sassythesasquatchh/Aeroponics-Module/Electrical Subsytem/Power Requirements.xlsx

Item | Quantity | Current (mA) | Voltage (V) | Power (W) | Total Current (mA) | Total Power (W)
Main Pump | 1 | 300 | 120 | 20 | 300 | 20
Nutrient Pump | 2 | 40 | 120 | 3 | 80 | 6
Subtotal |  |  |  |  | 380 | 26
Arduino | 1 | 50 | 5 | 0.25 | 50 | 0.25
ESP32 | 1 | 250 | 3.3 | 0.825 | 250 | 0.825
TDS | 1 | 6 | 3.3 | 0.0198 | 6 | 0.0198
PH | 1 | 10 | 5 | 0.05 | 10 | 0.05
Light | 1 | 0.02 | 5 | 0.0001 | 0.02 | 0.0001
CO2 | 1 | 125 | 5 | 0.625 | 125 | 0.625
O2 | 1 | 100 | 5 | 0.5 | 100 | 0.5
Subtotal |  |  |  |  | 541.02 | 2.2699
Total |  |  |  |  | 921.02 | 28.2699
Item | Quantity | Current (mA) | Voltage (V) | Power (W) | Total Current (mA) | Total Power (W)
Main Pump | 1 | 300 | 120 | 20 | 300 | 20
Nutrient Pump | 2 | 40 | 120 | 3 | 80 | 6
Subtotal |  |  |  |  | 380 | 26
Arduino | 1 | 50 | 5 | 0.25 | 50 | 0.25
ESP32 | 1 | 250 | 5 | 1.25 | 250 | 1.25
TDS | 1 | 6 | 5 | 0.03 | 6 | 0.03
PH | 1 | 10 | 5 | 0.05 | 10 | 0.05
Light | 1 | 0.02 | 5 | 0.0001 | 0.02 | 0.0001
CO2 | 1 | 125 | 5 | 0.625 | 125 | 0.625
O2 | 1 | 100 | 5 | 0.5 | 100 | 0.5
Subtotal |  |  |  |  | 541.02 | 2.7051
Total |  |  |  |  | 921.02 | 28.7051
