sassythesasquatchh/Aeroponics-Module/App/AWS_Flow_Diagram.png

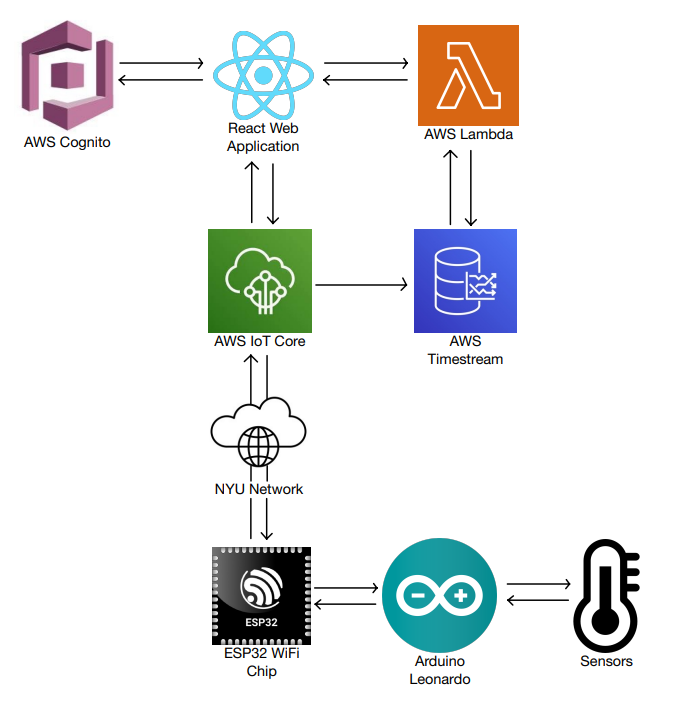
App/AWS_Flow_Diagram.png
