sassythesasquatchh/Aeroponics-Module/Electrical Subsytem/3-Pumps-Driver Layout.png

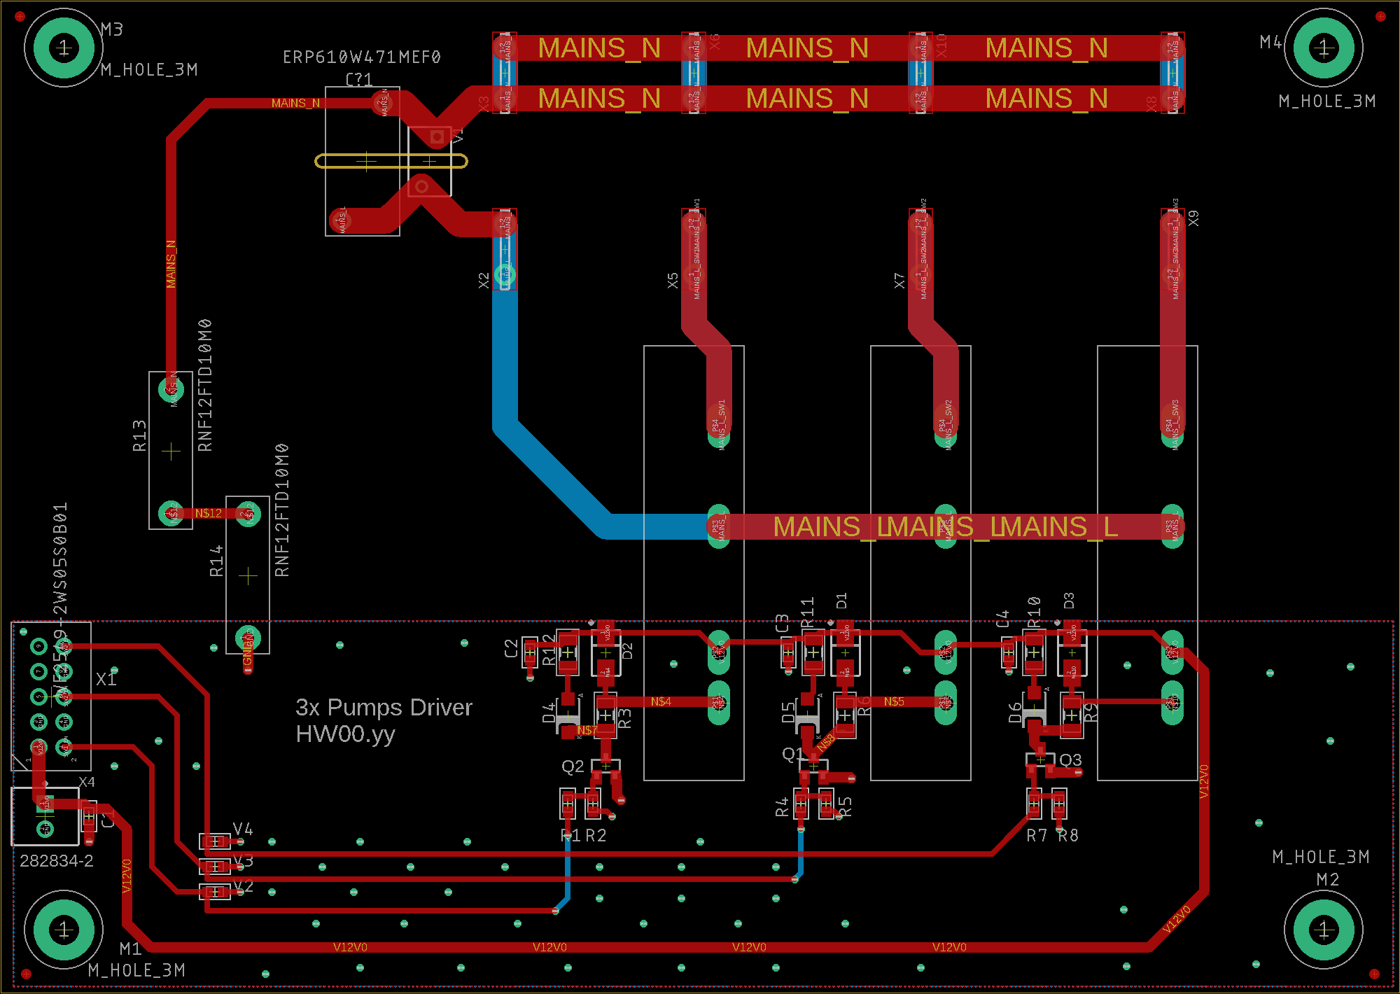
Electrical Subsytem/3-Pumps-Driver Layout.png
