sassythesasquatchh/Aeroponics-Module/Electrical Subsytem/3-Pumps-Driver.png

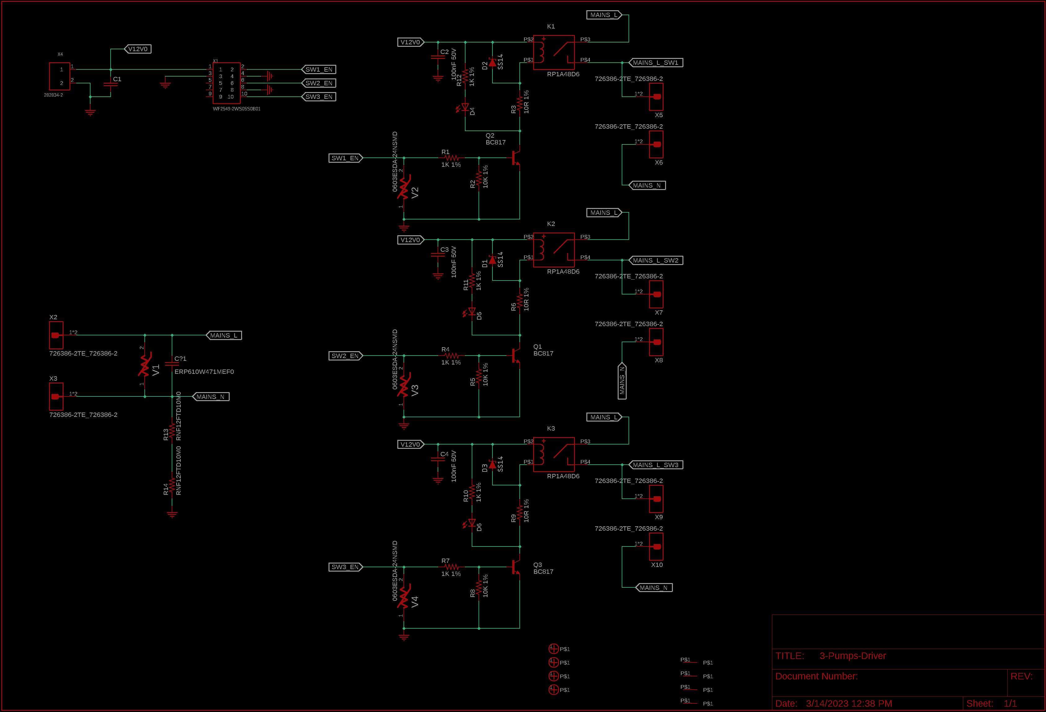
Electrical Subsytem/3-Pumps-Driver.png
