sassythesasquatchh/Aeroponics-Module/Electrical Subsytem/Dosing Control Diagram.png

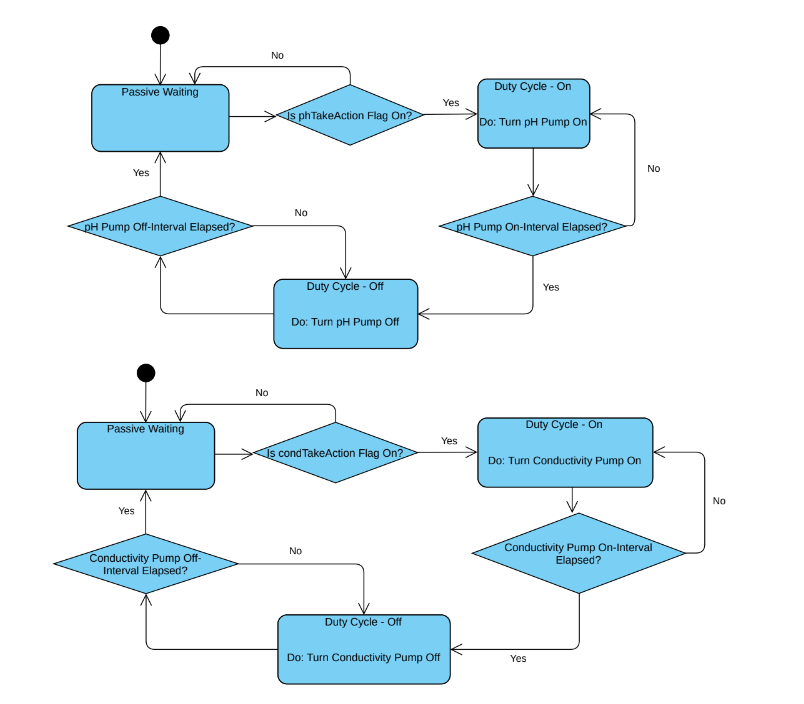
Electrical Subsytem/Dosing Control Diagram.png
