sassythesasquatchh/Aeroponics-Module/Electrical Subsytem/Schematic.jpg

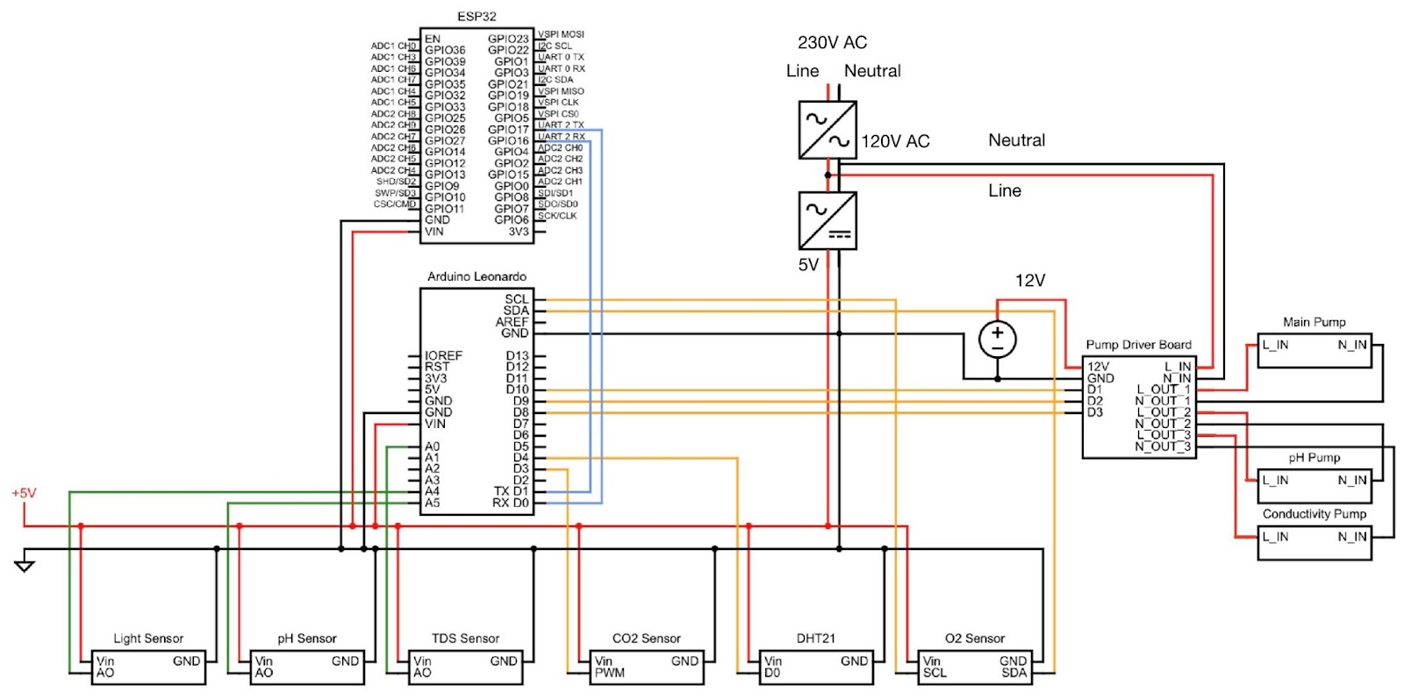
Electrical Subsytem/Schematic.jpg
