sassythesasquatchh/Aeroponics-Module/Bill of Materials.xlsx

Item Name | Quantity | Cost per unit ($) | Total Cost per Item ($) | Total Cost ($)
Main Pump (https://www.amazon.com/EcoPlus-Submersible-Aquarium-Fountain-Hydroponics/dp/B0018X2XT4) | 1 | 28.8 | 28.8 | 911.328
Conductivity Sensor (https://www.amazon.com/Conductivity-Hydroponics-Waterproof-Monitoring-Detection/dp/B08SQGL728) | 1 | 17.43 | 17.43
pH Sensor (https://www.amazon.com/dp/B0799BXMVJ/?coliid=I15NAHT9G5DQEI&colid=10N2NBCQJFRYH) | 1 | 34.99 | 34.99
PVC Elbow Joints 0.5in (https://www.amazon.com/Rainbow-Dream-2-Inch-Degree-Elbow/dp/B092MJ3T72) | 1 | 0.93 | 0.93
PVC Pipe (5ft) (https://www.mcmaster.com/products/pipe/standard-wall-plastic-pipe-for-water/?s=pvc+pipe) | 1 | 7.8 | 7.8
Marine Grade Plywood Cladding (1/2"x48"x96") (https://www.mcmaster.com/1125T613/) | 6 | 30.75 | 184.5
Arduino Leonardo (https://www.amazon.com/ELEGOO-Board-ATmega328P-ATMEGA16U2-Compliant/dp/B01EWOE0UU) | 1 | 25 | 25
ESP32 Development Board (https://www.amazon.com/Teyleten-Robot-ESP-WROOM-32-Development-Microcontroller/dp/B08246MCL5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) | 1 | 6 | 6
Timber Framing (2x4x96") (https://www.mcmaster.com/products/timber/wood-boards/) | 8.2 | 5.79 | 47.478
Plastic Sheeting (0.023"x24"x45") (https://www.mcmaster.com/products/plastic-sheets/slippery-uhmw-polyethylene-film/) | 10 | 9.09 | 90.9
WiFi Antenna (https://www.amazon.com/Diymall-Antenna-Antennas-Arduino-ESP-072pcs/dp/B00ZBJNO9O) | 1 | 5 | 5
Heavy Duty Velcro (1"x20') (https://www.amazon.com/VELCRO-Brand-Mounting-Adhesive-Concrete/dp/B09BNPHCZX) | 1 | 17.09 | 17.09
PVC Stop Valve (https://www.mcmaster.com/products/stop-valves/for-use-with~water/body-material~plastic/easy-to-install-plastic-threaded-on-off-valves/) | 1 | 34.33 | 34.33
Temperature and Humidity Sensor (https://www.amazon.com/HiLetgo-Temperature-Humidity-Digital-3-3V-5V/dp/B01DKC2GQ0) | 1 | 2 | 2
Breadboard wires (https://www.amazon.com/EDGELEC-Breadboard-Optional-Assorted-Multicolored/dp/B07GD2BWPY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) | 1 | 6.89 | 6.89
Plant wells (https://www.amazon.com/50-Pack-Garden-Slotted-Labels-Hydroponics/dp/B07CVCHM5T) | 1 | 10.95 | 10.95
Misting Nozzles (https://www.amazon.com/Tefen-Plastic-Fogger-Misting-Nozzle/dp/B07YQ4VQ7X) | 1 | 59 | 59
Light Sensors (https://www.amazon.com/HiLetgo-TEMT6000-Sensor-Professional-Arduino/dp/B07WDW9BHD) | 1 | 2.67 | 2.67
CO2 sensor (https://www.amazon.com/DFRobot-Gravity-Analog-Infrared-Arduino/dp/B07CG726Y3) | 1 | 63 | 63
Oxygen Sensor (https://www.amazon.com/Gravity-Compatible-Sensitivity-Stablility-Anti-Interference/dp/B08BL1NLGV) | 1 | 58.9 | 58.9
PermaProto Boards (https://www.amazon.com/Adafruit-Accessories-Perma-Proto-Full-Breadboard/dp/B00SK8KAMM) | 1 | 8.33 | 8.33
Small Nutrient Pump (https://www.amazon.com/Aquaneat-Submersible-Adjustable-Powerhead-Hydroponic/dp/B077955YC2) | 2 | 6.17 | 12.34
Polystyrene Insulation (6pcs@1"x24"x4') (https://www.mcmaster.com/products/polystyrene/moisture-resistant-low-temperature-rigid-polystyrene-foam-insulation-sheets/) | 2.2 | 85 | 187
Pump Driver Board | 1 | 50 | 50
Item Name | Quantity | Cost/unit ($) | Cost/Item ($) | Total Cost ($)
Main Pump (https://www.amazon.com/EcoPlus-Submersible-Aquarium-Fountain-Hydroponics/dp/B0018X2XT4) | 1 | 28.8 | 28.8 | 2610.7
Conductivity Sensor (https://www.amazon.com/Conductivity-Hydroponics-Waterproof-Monitoring-Detection/dp/B08SQGL728) | 2 | 17.43 | 34.86
pH Sensor (https://www.amazon.com/dp/B0799BXMVJ/?coliid=I15NAHT9G5DQEI&colid=10N2NBCQJFRYH) | 2 | 34.99 | 69.98
PVC Elbow Joints 0.5in (https://www.amazon.com/Rainbow-Dream-2-Inch-Degree-Elbow/dp/B092MJ3T72) | 15 | 0.93 | 13.95
PVC Pipe (5ft) (https://www.mcmaster.com/products/pipe/standard-wall-plastic-pipe-for-water/?s=pvc+pipe) | 1 | 7.8 | 7.8
Marine Grade Plywood Cladding (1/2"x48"x96") (https://www.mcmaster.com/products/timber/plywood-sheets/) | 3 | 216.66 | 649.98
Arduino Leonardo (https://www.amazon.com/ELEGOO-Board-ATmega328P-ATMEGA16U2-Compliant/dp/B01EWOE0UU) | 1 | 25 | 25
ESP32 Development Board (https://www.amazon.com/Teyleten-Robot-ESP-WROOM-32-Development-Microcontroller/dp/B08246MCL5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) | 3 | 6 | 18
Aluminium Framing 40mmx40mmx10ft (https://www.mcmaster.com/products/~/t-slotted-framing-rails-4/?s=aluminium+frame) | 7 | 81.56 | 570.92
Plastic Sheeting (0.02"x24"x1') (https://www.mcmaster.com/products/plastic-sheets/slippery-uhmw-polyethylene-film/) | 10 | 13.75 | 137.5
WiFi Antenna (https://www.amazon.com/Diymall-Antenna-Antennas-Arduino-ESP-072pcs/dp/B00ZBJNO9O) | 1 | 5 | 5
Heavy Duty Velcro (1"x20') (https://www.amazon.com/VELCRO-Brand-Mounting-Adhesive-Concrete/dp/B09BNPHCZX) | 1 | 17.09 | 17.09
PVC Stop Valve (https://www.mcmaster.com/products/stop-valves/for-use-with~water/body-material~plastic/easy-to-install-plastic-threaded-on-off-valves/) | 1 | 34.33 | 34.33
Temperature and Humidity Sensor (https://www.amazon.com/HiLetgo-Temperature-Humidity-Digital-3-3V-5V/dp/B01DKC2GQ0) | 5 | 2 | 10
Breadboard wires (https://www.amazon.com/EDGELEC-Breadboard-Optional-Assorted-Multicolored/dp/B07GD2BWPY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) | 1 | 6.89 | 6.89
Plant wells (https://www.amazon.com/50-Pack-Garden-Slotted-Labels-Hydroponics/dp/B07CVCHM5T) | 1 | 10.95 | 10.95
Misting Nozzles (https://www.amazon.com/Tefen-Plastic-Fogger-Misting-Nozzle/dp/B07YQ4VQ7X) | 1 | 59 | 59
Light Sensors (https://www.amazon.com/HiLetgo-TEMT6000-Sensor-Professional-Arduino/dp/B07WDW9BHD) | 3 | 2.67 | 8.01
CO2 sensor (https://www.amazon.com/DFRobot-Gravity-Analog-Infrared-Arduino/dp/B07CG726Y3) | 1 | 63 | 63
Oxygen Sensor (https://www.amazon.com/Gravity-Compatible-Sensitivity-Stablility-Anti-Interference/dp/B08BL1NLGV) | 1 | 58.9 | 58.9
PermaProto Boards (https://www.amazon.com/Adafruit-Accessories-Perma-Proto-Full-Breadboard/dp/B00SK8KAMM) | 3 | 8.33 | 24.99
Small Nutrient Pump (https://www.amazon.com/Aquaneat-Submersible-Adjustable-Powerhead-Hydroponic/dp/B077955YC2) | 3 | 6.17 | 18.51
Foam Insulation (54"x1"x1') (https://www.mcmaster.com/products/insulation/polyurethane-foam-insulation-sheets-with-perforated-facing/) | 24 | 23.61 | 566.64
Professional pH and EC Probe (https://www.amazon.com/Apera-Instruments-Conductivity-Multi-Parameter-Replaceable/dp/B01ENFOIKA) | 1 | 120.6 | 120.6
Pump Driver Board | 1 | 50 | 50
