sassythesasquatchh/Aeroponics-Module/Solidworks Files/Plant_basket_print.STL

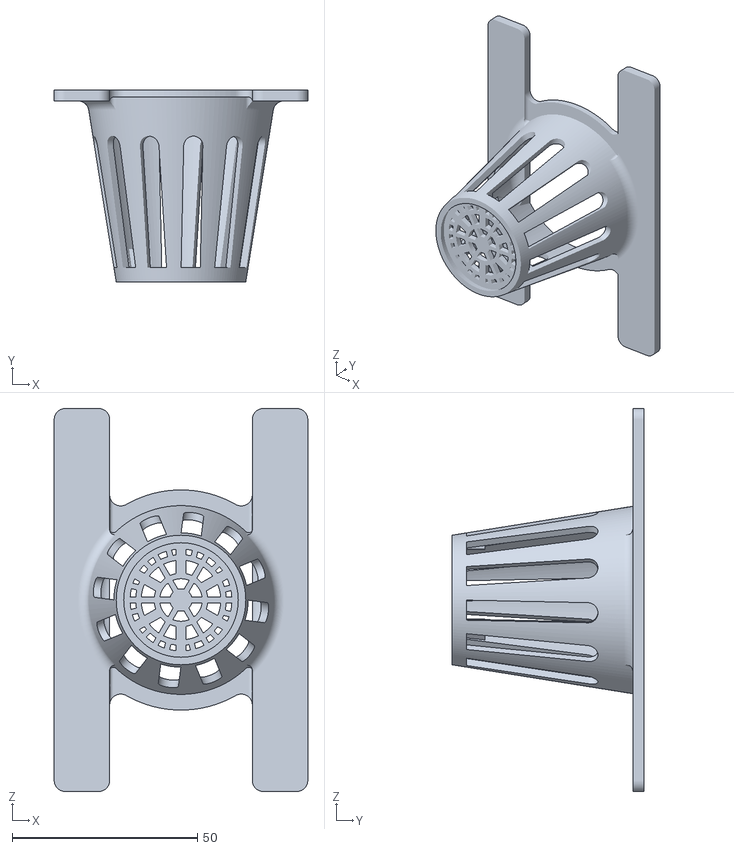
[picture p6: CAD file, 2023-05-08]
Solidworks Files/Plant_basket_print.STL
68.5 x 52.0 x 103.5
