sassythesasquatchh/Aeroponics-Module/(list of files, cad)

Other CAD files:
Solidworks Files/Plant_basket.SLDPRT
