sassythesasquatchh/Aeroponics-Module/Technical Drawings/frame_drawing_with_holes.PDF

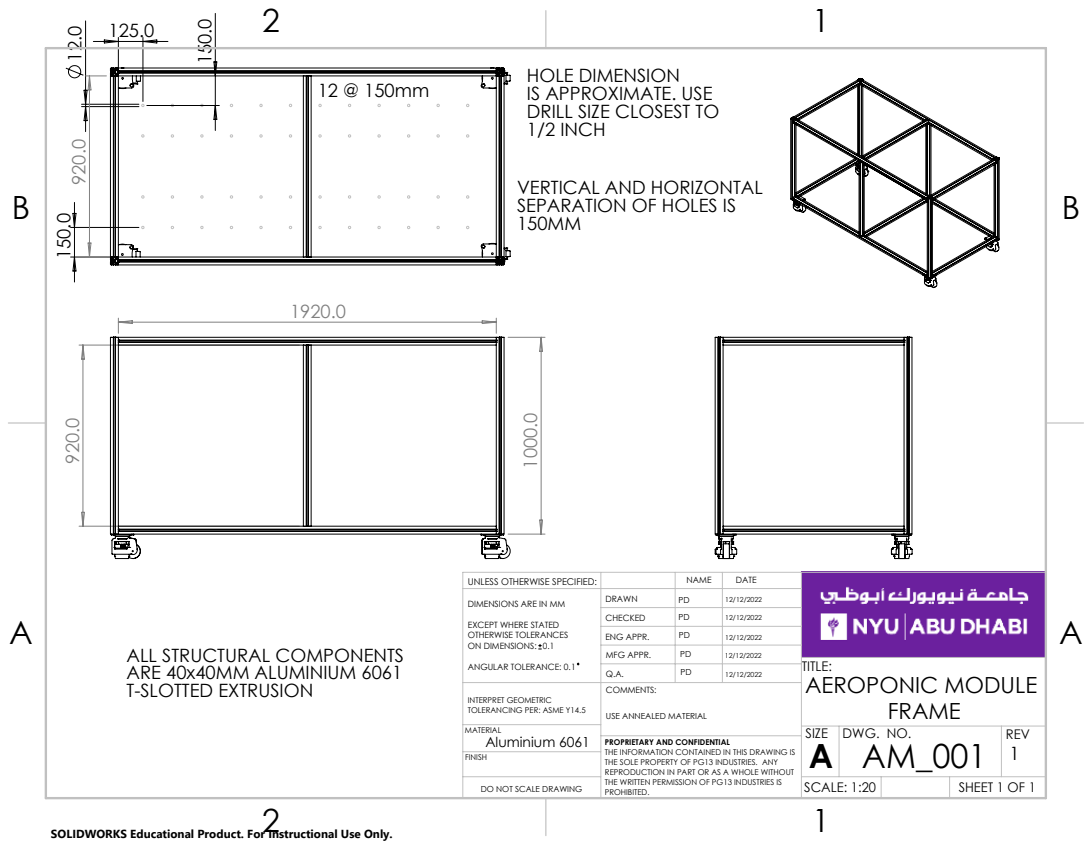
[picture p7: page 1]
DWG. NO.; DO NOT SCALE DRAWING; SCALE: 1:20; SHEET 1 OF 1; AEROPONIC MODULE; THE INFORMATION CONTAINED IN THIS DRAWING IS; 1 THE SOLE PROPERTY OF PG13 INDUSTRIES. ANY; Aluminium 6061

HOLE DIMENSION
IS APPROXIMATE. USE
DRILL SIZE CLOSEST TO
1/2 INCH

VERTICAL AND HORIZONTAL
SEPARATION OF HOLES IS

UNLESS OTHERWISE SPECIFIED: | | NAME | DATE
DIMENSIONS ARE IN MM EXCEPT WHERE STATED OTHERWISE TOLERANCES ON DIMENSIONS: 0.1 ANGULAR TOLERANCE: 0.1 | DRAWN | PD | 12/12/2022

CHECKED | PD | 12/12/2022
ENG APPR. | PD | 12/12/2022
MFG APPR. | PD | 12/12/2022
Q.A. | PD | 12/12/2022

ALL STRUCTURAL COMPONENTS
ARE 40x40MM ALUMINIUM 6061
T-SLOTTED EXTRUSION

INTERPRET GEOMETRIC TOLERANCING PER: ASME Y14.5 | COMMENTS: USE ANNEALED MATERIAL

PROPRIETARY AND CONFIDENTIAL

REPRODUCTION IN PART OR AS A WHOLE WITHOUT
THE WRITTEN PERMISSION OF PG13 INDUSTRIES IS
PROHIBITED.

SOLIDWORKS Educational Product. For Instructional Use Only.
